JosephStew-art/autopilot-h743/README.md

STM32H743 autopilot board designed in KiCad. V2 routing is complete silkscreen cleanup remains.

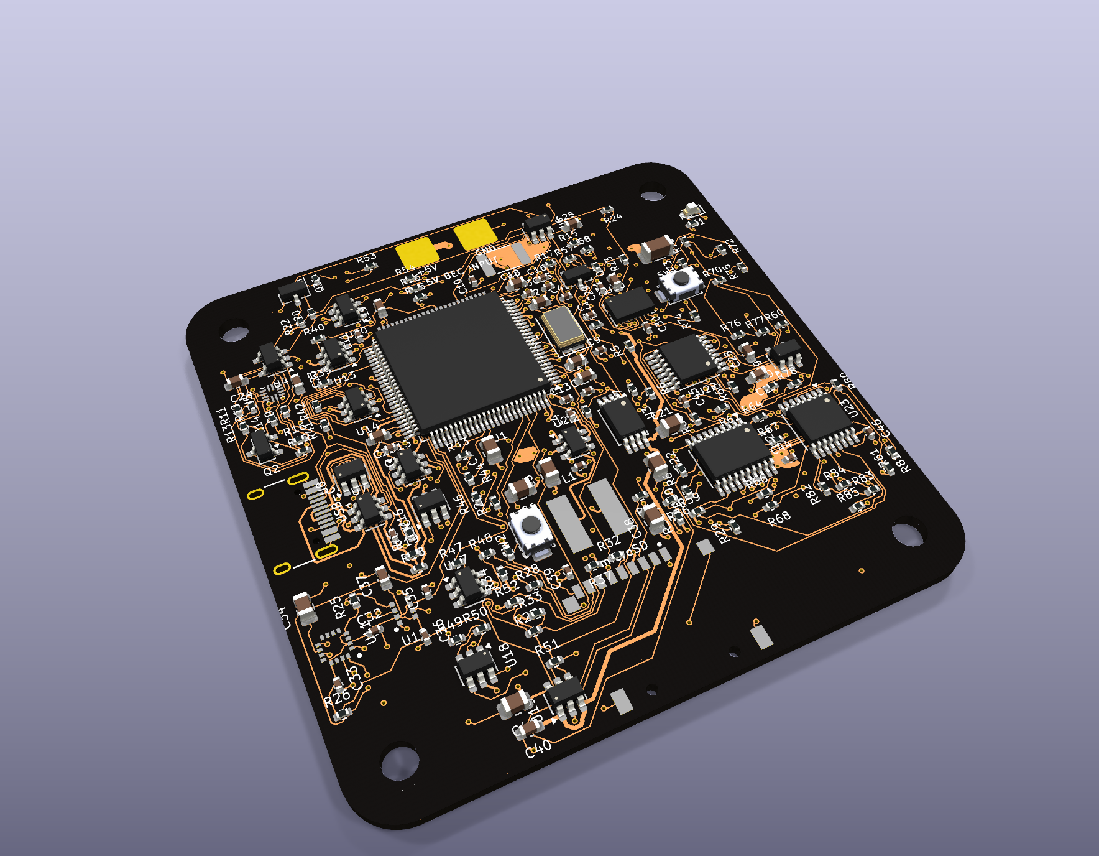
[picture p1: images/board-3d.png]
V2 board — top


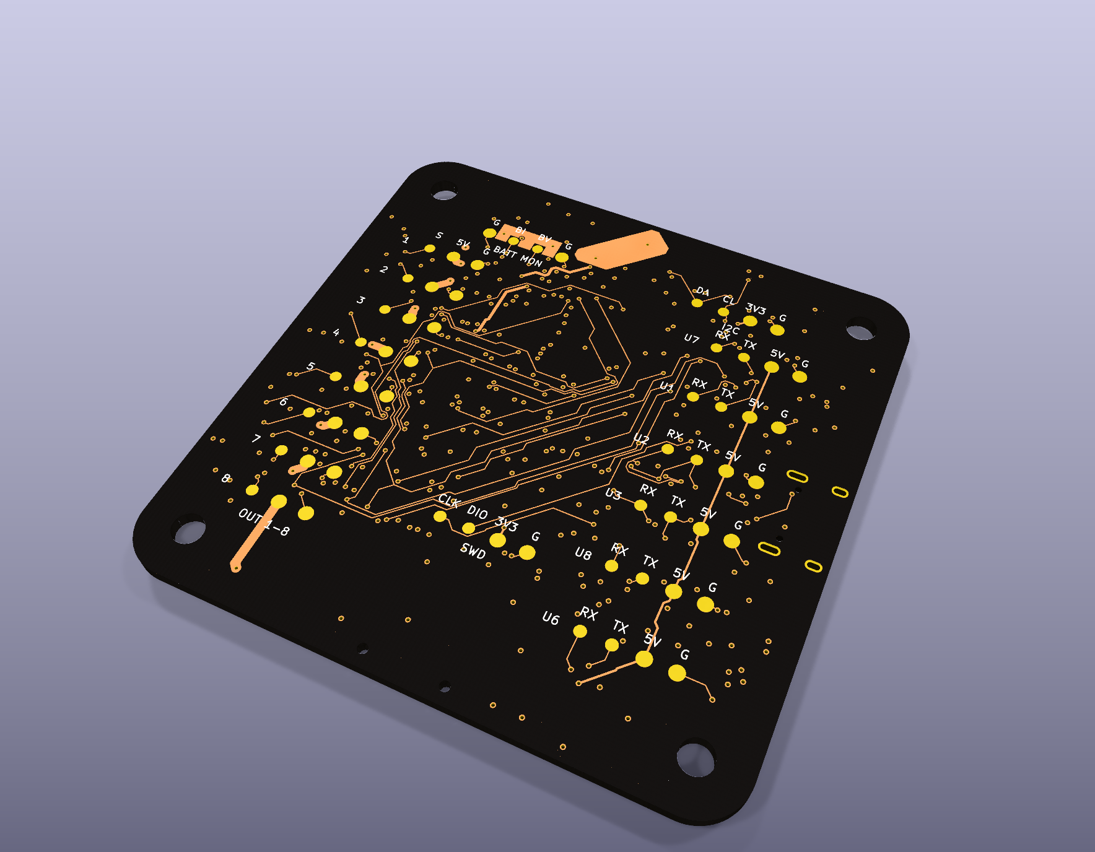
[picture p2: images/board-3d-bottom.png]
V2 board — bottom
