JosephStew-art/autopilot-h743/Autopilot_H743_V2.kicad_pcb

## KiCad design Autopilot_H743_V2.kicad_pcb (2026-10-12)

Schematic: Autopilot_H743_V2.kicad_sch, H743 compact autopilot — revision two

Parts:
C1, C2: 33pF; Capacitor_SMD__C_0603_1608Metric; Rating 33pF / 100V C0G; MPN GCM1885C2A330JA16D; LCSC C126578
C3, C4, C8, C9, C10, C11, C12, C13, C14, C15, C16, C26, C29, C30, C32, C33, C35, C36, C39, C42, C43, C44, C45, C46: 100nF; C_0402_1005Metric; Rating 100nF / 16V X7R; MPN CL05B104KO5NNNC; LCSC C1525
C5, C6, C22, C34: 22uF; Capacitor_SMD__C_0805_2012Metric; Rating 22uF / 25V X5R; MPN CL21A226MAQNNNE; LCSC C45783
C7, C21, C38, C41: 10uF; Capacitor_SMD__C_0805_2012Metric; Rating 10uF / 35V X5R; MPN GRM21BR6YA106KE43L; LCSC C162422
C17, C28: 4.7uF; Capacitor_SMD__C_0603_1608Metric; Rating 4.7uF / 16V X5R; MPN CL10A475KO8NNNC; LCSC C19666
C18, C23, C24, C25, C27, C31, C37, C40: 1uF; Capacitor_SMD__C_0603_1608Metric; Rating 1uF / 50V X5R; MPN CL10A105KB8NNNC; LCSC C15849
C19, C20: 2.2uF; Capacitor_SMD__C_0603_1608Metric; Rating 2.2uF / 16V X5R; MPN CL10A225KO8NNNC; LCSC C23630
C47: 47uF; Capacitor_SMD__C_1206_3216Metric; Rating 47uF / 10V X5R; DC-bias derating applies; MPN CL31A476MPHNNNE; LCSC C96123
D1: RED; LED_SMD__LED_0603_1608Metric; Rating RED / status; MPN KT-0603R; LCSC C2286
F1: 1.5A hold; Fuse__Fuse_1812_4532Metric; Rating 1.5A hold / 16V; MPN SMD1812P150TF/16; LCSC C20810
J2: 5V BEC INPUT PADS; PowerInput_2Pad_4x4mm_P7mm; Rating Regulated 4.75-5.25 V; shared avionics 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
J3: TYPE-C-31-M-12; Connector_USB__USB_C_Receptacle_HRO_TYPE-C-31-M-12; Rating TYPE-C-31-M-12; MPN TYPE-C-31-M-12; LCSC C165948
J4: TF-01A / microSD; TF-01A; Rating TF-01A / microSD; MPN TF-01A; LCSC C91145
L1: 4.7uH; SRN6045; Rating 4.7uH / Irms3A / Isat4A; MPN SRN6045-4R7Y; LCSC C780210
Q1: AO3401A; Package_TO_SOT_SMD__SOT-23; Rating AO3401A; MPN AO3401A; LCSC C15127
Q2: MMBT3906 PNP; Package_TO_SOT_SMD__SOT-23; Rating MMBT3906 PNP; MPN MMBT3906 2A(RANGE:100-300); LCSC C2143
Q3: MMBT2222A NPN; Package_TO_SOT_SMD__SOT-23; Rating MMBT2222A NPN; MPN MMBT2222A 1P; LCSC C8512
R1, R2, R8, R12, R13, R17, R22, R23, R24, R38, R52, R59, R60, R61: 10k; R_0402_1005Metric; Rating 10k / 1% / 62.5mW; MPN 0402WGF1002TCE; LCSC C25744
R3, R57, R58: 1k; R_0402_1005Metric; Rating 1k / 1% / 62.5mW; MPN 0402WGF1001TCE; LCSC C11702
R4, R5, R14, R16, R20, R21, R62, R63, R64, R65, R66, R67, R68, R69, R71, R73, R75, R77, R79, R81, R83, R85: 100k; R_0402_1005Metric; Rating 100k / 1% / 62.5mW; MPN 0402WGF1003TCE; LCSC C25741
R6: 24k; R_0402_1005Metric; Rating 24k / 1% / 62.5mW; MPN 0402WGF2402TCE; LCSC C25769
R7: 470; R_0402_1005Metric; Rating 470 / 1% / 62.5mW; MPN 0402WGF4700TCE; LCSC C25117
R9, R10, R11: 300k; R_0402_1005Metric; Rating 300k / 1% / 62.5mW; MPN 0402WGF3003TCE; LCSC C25774
R15: 20k; R_0402_1005Metric; Rating 20k / 1% / 62.5mW; MPN 0402WGF2002TCE; LCSC C25765
R18, R19, R27, R28, R29, R30, R31, R32, R39, R40, R41, R42, R43, R44, R45, R46, R47, R48, R49, R50, R53, R54, R70, R72, R74, R76, R78, R80, R82, R84: 33; R_0402_1005Metric; Rating 33 / 1% / 62.5mW; MPN 0402WGF330JTCE; LCSC C25105
R25, R26, R55, R56: 4.7k; R_0402_1005Metric; Rating 4.7k / 1% / 62.5mW; MPN 0402WGF4701TCE; LCSC C25900
R33, R34, R35, R36, R37, R51: 49.9k; R_0402_1005Metric; Rating 49.9k / 1% / 62.5mW; MPN 0402WGF4992TCE; LCSC C25897
SW1: RESET; SW_TS-1088-AR02016; Rating RESET; MPN TS-1088-AR02016; LCSC C720477
SW2: BOOT; SW_TS-1088-AR02016; Rating BOOT; MPN TS-1088-AR02016; LCSC C720477
TP1, TP29: V3V3_CORE; SolderPad_D1.5mm; Rating V3V3_CORE
TP2: SWDIO; SolderPad_D1.2mm; Rating SWDIO
TP3: SWCLK; SolderPad_D1.2mm; Rating SWCLK
TP4, TP8, TP12, TP16, TP20, TP24, TP28, TP32, TP33, TP36, TP37, TP40, TP43, TP46, TP49, TP52, TP55, TP58: GND; SolderPad_D1.5mm; Rating GND
TP5, TP9, TP13, TP17, TP21, TP25: V5_PERIPH; SolderPad_D1.5mm; Rating V5_PERIPH
TP6: UART7_TX_EXT; SolderPad_D1.2mm; Rating UART7_TX_EXT
TP7: UART7_RX_EXT; SolderPad_D1.2mm; Rating UART7_RX_EXT
TP10: USART1_TX_EXT; SolderPad_D1.2mm; Rating USART1_TX_EXT
TP11: USART1_RX_EXT; SolderPad_D1.2mm; Rating USART1_RX_EXT
TP14: USART2_TX_EXT; SolderPad_D1.2mm; Rating USART2_TX_EXT
TP15: USART2_RX_EXT; SolderPad_D1.2mm; Rating USART2_RX_EXT
TP18: USART3_TX_EXT; SolderPad_D1.2mm; Rating USART3_TX_EXT
TP19: USART3_RX_EXT; SolderPad_D1.2mm; Rating USART3_RX_EXT
TP22: UART8_TX_EXT; SolderPad_D1.2mm; Rating UART8_TX_EXT
TP23: UART8_RX_EXT; SolderPad_D1.2mm; Rating UART8_RX_EXT
TP26: USART6_TX_EXT; SolderPad_D1.2mm; Rating USART6_TX_EXT
TP27: USART6_RX_EXT; SolderPad_D1.2mm; Rating USART6_RX_EXT
TP30: I2C1_SCL_EXT; SolderPad_D1.2mm; Rating I2C1_SCL_EXT
TP31: I2C1_SDA_EXT; SolderPad_D1.2mm; Rating I2C1_SDA_EXT
TP34: BATT_V_IN; SolderPad_D1.2mm; Rating BATT_V_IN
TP35: BATT_I_IN; SolderPad_D1.2mm; Rating BATT_I_IN
TP38, TP41, TP44, TP47, TP50, TP53, TP56, TP59: V5_MAIN_IN; SolderPad_D1.5mm; Rating V5_MAIN_IN
TP39: PWM1_OUT; SolderPad_D1.2mm; Rating PWM1_OUT
TP42: PWM2_OUT; SolderPad_D1.2mm; Rating PWM2_OUT
TP45: PWM3_OUT; SolderPad_D1.2mm; Rating PWM3_OUT
TP48: PWM4_OUT; SolderPad_D1.2mm; Rating PWM4_OUT
TP51: PWM5_OUT; SolderPad_D1.2mm; Rating PWM5_OUT
TP54: PWM6_OUT; SolderPad_D1.2mm; Rating PWM6_OUT
TP57: PWM7_OUT; SolderPad_D1.2mm; Rating PWM7_OUT
TP60: PWM8_OUT; SolderPad_D1.2mm; Rating PWM8_OUT
U1: STM32H743VIT6; Package_QFP__LQFP-100_14x14mm_P0.5mm; Rating STM32H743VIT6; MPN STM32H743VIT6; LCSC C114409
U2: AP63203WU-7; Package_TO_SOT_SMD__TSOT-23-6; Rating AP63203WU-7; MPN AP63203WU-7; LCSC C780769
U3: TPS2113APWR; Package_SO__TSSOP-8_4.4x3mm_P0.65mm; Rating TPS2113APWR; MPN TPS2113APWR; LCSC C130052
U4, U9: TPS7A2033PDBVR; Package_TO_SOT_SMD__SOT-23-5; Rating TPS7A2033PDBVR; MPN TPS7A2033PDBVR; LCSC C2862740
U5: TUSB320LIRWBR; Package_DFN_QFN__Texas_X2QFN-12_1.6x1.6mm_P0.4mm; Rating TUSB320LIRWBR; MPN TUSB320LIRWBR; LCSC C2836598
U6, U19: TPS2553DBVR; Package_TO_SOT_SMD__SOT-23-6; Rating TPS2553DBVR; MPN TPS2553DBVR; LCSC C55266
U7, U8, U13, U14, U15, U16, U17, U18, U20: USBLC6-2SC6; Package_TO_SOT_SMD__SOT-23-6; Rating USBLC6-2SC6; MPN USBLC6-2SC6; LCSC C7519
U10: BMI088; Package_LGA__Bosch_LGA-16_4.5x3mm_P0.5mm_LayoutBorder7x1y_C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; Rating BMI088; MPN BMI088; LCSC C194919
U11: MMC5983MA; Rating MMC5983MA; MPN MMC5983MA; LCSC C404329
U12: SPA06-003; Rating SPA06-003; MPN SPA06-003; LCSC C30589048
U21: SN74LV8T245PWR; Package_SO__TSSOP-20_4.4x6.5mm_P0.65mm; Rating SN74LV8T245PWR; MPN SN74LV8T245PWR; LCSC C20345798
U22, U23: TMUX1574PWR; Package_SO__TSSOP-16_4.4x5mm_P0.65mm; Rating TMUX1574PWR; MPN TMUX1574PWR; LCSC C2673443
Y1: 8MHz; Crystal__Crystal_SMD_5032-2Pin_5.0x3.2mm; Rating 8MHz / CL20pF; MPN X50328MSB2GI; LCSC C115962

Connections:
/ACTUATOR_OE_N: R59.2, U1.57 (PD10), U21.19 (OE_N), U22.15 (EN_N), U23.15 (EN_N)
/ADC_BATT_I: C43.1, R58.2, U1.16 (PC1)
/ADC_BATT_V: C42.1, R57.2, U1.15 (PC0)
/BATT_I_IN: R58.1, TP35.1
/BATT_V_IN: R57.1, TP34.1
/BOOT0: R2.1, SW2.2, U1.94 (BOOT0)
/BUCK_BST: C4.1, U2.6 (BST)
/BUCK_SW: C4.2, L1.1, U2.5 (SW)
/CC_HIGH_CURRENT_N: R12.2, R13.1, U5.7 (OUT1)
/CC_VBUS_DET: R11.2, U5.4 (VBUS_DET)
/CC_VBUS_R1: R9.2, R10.1
/CC_VBUS_R2: R10.2, R11.1
/GND: C1.2, C2.2, C3.2, C5.2, C6.2, C7.2, C8.2, C9.2, C10.2, C11.2, C12.2, C13.2, C14.2, C15.2, C16.2, C17.2, C18.2, C19.2, C20.2, C21.2, C22.2, C23.2, C24.2, C25.2, C26.2, C27.2, C28.2, C29.2, C30.2, C31.2, C32.2, C33.2, C34.2, C35.2, C36.2, C37.2, C38.2, C39.2, C40.2, C41.2, C42.2, C43.2, C44.2, C45.2, C46.2, C47.2, D1.1 (K), J2.1 (GND), J3.A1 (GND), J3.A12 (GND), J3.B1 (GND), J3.B12 (GND), J3.S1 (SHIELD), J4.6 (VSS), J4.10 (SHIELD), Q3.2 (E), R2.2, R4.2, R6.2, R7.2, R15.2, R16.2, R21.2, R51.2, R60.2, R61.2, R62.2, R63.2, R64.2, R65.2, R66.2, R67.2, R68.2, R69.2, R71.2, R73.2, R75.2, R77.2, R79.2, R81.2, R83.2, R85.2, SW1.2, TP4.1, TP8.1, TP12.1, TP16.1, TP20.1, TP24.1, TP28.1, TP32.1, TP33.1, TP36.1, TP37.1, TP40.1, TP43.1, TP46.1, TP49.1, TP52.1, TP55.1, TP58.1, U1.10 (VSS), U1.19 (VSSA), U1.26 (VSS), U1.49 (VSS), U1.74 (VSS), U1.99 (VSS), U2.4 (GND), U3.2 (EN_N), U3.5 (GND), U4.2 (GND), U5.3 (PORT), U5.10 (GND), U5.11 (EN_N), U6.2 (GND), U7.2 (GND), U8.2 (GND), U9.2 (GND), U10.2 (GNDA), U10.4 (GNDA), U10.6 (GNDIO), U10.7 (PS), U11.9 (GND), U11.11 (GND), U12.1 (GND), U12.5 (ADDR_I2C), U12.7 (GND), U13.2 (GND), U14.2 (GND), U15.2 (GND), U16.2 (GND), U17.2 (GND), U18.2 (GND), U19.2 (GND), U20.2 (GND), U21.10 (GND), U22.8 (GND), U23.8 (GND)
/HSE_IN: C1.1, U1.12 (PH0), Y1.1
/HSE_OUT: C2.1, U1.13 (PH1), Y1.2
/I2C1_SCL: R53.1, R55.2, U1.92 (PB6)
/I2C1_SCL_EXT: R53.2, TP30.1, U20.1 (I/O1), U20.6 (I/O1)
/I2C1_SDA: R54.1, R56.2, U1.93 (PB7)
/I2C1_SDA_EXT: R54.2, TP31.1, U20.3 (I/O2), U20.4 (I/O2)
/I2C2_SCL: R25.2, U1.46 (PB10), U11.1 (SCL), U12.4 (SCK)
/I2C2_SDA: R26.2, U1.47 (PB11), U11.16 (SDA), U12.3 (SDA)
/IMU_ACC_CS_N: R23.2, U1.9 (PC15), U10.14 (~CSB1)
/IMU_ACC_INT: U1.7 (PC13), U10.16 (INT1)
/IMU_GYR_CS_N: R24.2, U1.8 (PC14), U10.5 (~CSB2)
/IMU_GYR_INT: U1.1 (PE2), U10.12 (INT3)
/LED_STATUS_A: D1.2 (A), R3.2
/MAG_INT: U1.3 (PE4), U11.15 (INT)
/MAG_SETRESET_CAP: C34.1, U11.10 (CAP)
/MAIN_PMOS_GATE: Q1.1 (G), R4.1
/MAIN_VSNS: R5.2, R6.1, U3.3 (VSNS)
/MUX_ILIM: R7.1, U3.4 (ILIM)
/NRST: C3.1, R1.2, SW1.1, U1.14 (NRST)
/OTG_FS_DM: R19.2, U1.70 (PA11)
/OTG_FS_DP: R18.2, U1.71 (PA12)
/OUT_BANK1_DSHOT: R60.1, U1.58 (PD11), U22.1 (SEL_DSHOT)
/OUT_BANK2_DSHOT: R61.1, U1.84 (PD3), U23.1 (SEL_DSHOT)
/PERIPH_FAULT_N: R52.2, U1.4 (PE5), U19.4 (FAULT_N)
/PERIPH_ILIM: R51.1, U19.5 (ILIM)
/PWM1_5V: U21.18 (B1), U22.2 (S1A_PWM5V)
/PWM1_MCU: R62.1, U1.22 (PA0), U21.2 (A1), U22.3 (S1B_DSHOT)
/PWM1_OUT: R70.2, R71.1, TP39.1
/PWM1_SELECTED: R70.1, U22.4 (D1)
/PWM2_5V: U21.17 (B2), U22.5 (S2A_PWM5V)
/PWM2_MCU: R63.1, U1.23 (PA1), U21.3 (A2), U22.6 (S2B_DSHOT)
/PWM2_OUT: R72.2, R73.1, TP42.1
/PWM2_SELECTED: R72.1, U22.7 (D2)
/PWM3_5V: U21.16 (B3), U22.11 (S3A_PWM5V)
/PWM3_MCU: R64.1, U1.24 (PA2), U21.4 (A3), U22.10 (S3B_DSHOT)
/PWM3_OUT: R74.2, R75.1, TP45.1
/PWM3_SELECTED: R74.1, U22.9 (D3)
/PWM4_5V: U21.15 (B4), U22.14 (S4A_PWM5V)
/PWM4_MCU: R65.1, U1.25 (PA3), U21.5 (A4), U22.13 (S4B_DSHOT)
/PWM4_OUT: R76.2, R77.1, TP48.1
/PWM4_SELECTED: R76.1, U22.12 (D4)
/PWM5_5V: U21.14 (B5), U23.2 (S1A_PWM5V)
/PWM5_MCU: R66.1, U1.59 (PD12), U21.6 (A5), U23.3 (S1B_DSHOT)
/PWM5_OUT: R78.2, R79.1, TP51.1
/PWM5_SELECTED: R78.1, U23.4 (D1)
/PWM6_5V: U21.13 (B6), U23.5 (S2A_PWM5V)
/PWM6_MCU: R67.1, U1.60 (PD13), U21.7 (A6), U23.6 (S2B_DSHOT)
/PWM6_OUT: R80.2, R81.1, TP54.1
/PWM6_SELECTED: R80.1, U23.7 (D2)
/PWM7_5V: U21.12 (B7), U23.11 (S3A_PWM5V)
/PWM7_MCU: R68.1, U1.61 (PD14), U21.8 (A7), U23.10 (S3B_DSHOT)
/PWM7_OUT: R82.2, R83.1, TP57.1
/PWM7_SELECTED: R82.1, U23.9 (D3)
/PWM8_5V: U21.11 (B8), U23.14 (S4A_PWM5V)
/PWM8_MCU: R69.1, U1.62 (PD15), U21.9 (A8), U23.13 (S4B_DSHOT)
/PWM8_OUT: R84.2, R85.1, TP60.1
/PWM8_SELECTED: R84.1, U23.12 (D4)
/PWR_USB_SELECTED: R8.2, U1.96 (PB9), U3.1 (STAT)
/SDMMC1_CK: R32.1, U1.80 (PC12)
/SDMMC1_CMD: R31.1, U1.83 (PD2)
/SDMMC1_D0: R27.1, U1.65 (PC8)
/SDMMC1_D1: R28.1, U1.66 (PC9)
/SDMMC1_D2: R29.1, U1.78 (PC10)
/SDMMC1_D3: R30.1, U1.79 (PC11)
/SD_CLK_CARD: J4.5 (CLK), R32.2
/SD_CMD_CARD: J4.3 (CMD), R31.2, R37.2
/SD_D0_CARD: J4.7 (DAT0), R27.2, R33.2
/SD_D1_CARD: J4.8 (DAT1), R28.2, R34.2
/SD_D2_CARD: J4.1 (DAT2), R29.2, R35.2
/SD_D3_CARD: J4.2 (DAT3), R30.2, R36.2
/SD_DETECT_N: J4.9 (CD), R38.2, U1.95 (PB8)
/SPI1_MISO: U1.30 (PA6), U10.10 (SDO2), U10.15 (SDO1)
/SPI1_MOSI: U1.88 (PD7), U10.9 (SDI/SDA)
/SPI1_SCK: U1.29 (PA5), U10.8 (SCK/SCL)
/STATUS_LED: R3.1, U1.2 (PE3)
/SWCLK: TP3.1, U1.76 (PA14)
/SWDIO: TP2.1, U1.72 (PA13)
/UART7_RX: R40.2, U1.37 (PE7)
/UART7_RX_EXT: R40.1, TP7.1, U13.3 (I/O2), U13.4 (I/O2)
/UART7_TX: R39.1, U1.38 (PE8)
/UART7_TX_EXT: R39.2, TP6.1, U13.1 (I/O1), U13.6 (I/O1)
/UART8_RX: R48.2, U1.97 (PE0)
/UART8_RX_EXT: R48.1, TP23.1, U17.3 (I/O2), U17.4 (I/O2)
/UART8_TX: R47.1, U1.98 (PE1)
/UART8_TX_EXT: R47.2, TP22.1, U17.1 (I/O1), U17.6 (I/O1)
/USART1_RX: R42.2, U1.69 (PA10)
/USART1_RX_EXT: R42.1, TP11.1, U14.3 (I/O2), U14.4 (I/O2)
/USART1_TX: R41.1, U1.68 (PA9)
/USART1_TX_EXT: R41.2, TP10.1, U14.1 (I/O1), U14.6 (I/O1)
/USART2_RX: R44.2, U1.87 (PD6)
/USART2_RX_EXT: R44.1, TP15.1, U15.3 (I/O2), U15.4 (I/O2)
/USART2_TX: R43.1, U1.86 (PD5)
/USART2_TX_EXT: R43.2, TP14.1, U15.1 (I/O1), U15.6 (I/O1)
/USART3_RX: R46.2, U1.56 (PD9)
/USART3_RX_EXT: R46.1, TP19.1, U16.3 (I/O2), U16.4 (I/O2)
/USART3_TX: R45.1, U1.55 (PD8)
/USART3_TX_EXT: R45.2, TP18.1, U16.1 (I/O1), U16.6 (I/O1)
/USART6_RX: R50.2, U1.64 (PC7)
/USART6_RX_EXT: R50.1, TP27.1, U18.3 (I/O2), U18.4 (I/O2)
/USART6_TX: R49.1, U1.63 (PC6)
/USART6_TX_EXT: R49.2, TP26.1, U18.1 (I/O1), U18.6 (I/O1)
/USB_CC1: J3.A5 (CC1), U5.1 (CC1), U8.1 (I/O1), U8.6 (I/O1)
/USB_CC2: J3.B5 (CC2), U5.2 (CC2), U8.3 (I/O2), U8.4 (I/O2)
/USB_CONN_DM: J3.A7 (D-), J3.B7 (D-), R19.1, U7.3 (I/O2), U7.4 (I/O2)
/USB_CONN_DP: J3.A6 (D+), J3.B6 (D+), R18.1, U7.1 (I/O1), U7.6 (I/O1)
/USB_DETECT_BASE: Q3.1 (B), R20.2, R21.1
/USB_EN_PNP_BASE: Q2.1 (B), R13.2, R14.1
/USB_FAULT_N: R17.2, U1.5 (PE6), U6.4 (FAULT_N)
/USB_ILIM: R15.1, U6.5 (ILIM)
/USB_PRESENT_N: Q3.3 (C), R22.2, U1.32 (PC4)
/USB_PWR_EN: Q2.3 (C), R16.1, U6.3 (EN)
/USB_VBUS: C23.1, C26.1, J3.A4 (VBUS), J3.A9 (VBUS), J3.B4 (VBUS), J3.B9 (VBUS), R9.1, R20.1, U4.1 (IN), U4.3 (EN), U6.1 (IN), U7.5 (VBUS), U8.5 (VBUS)
/V3V3_CC: C24.1, Q2.2 (E), R12.1, R14.2, U4.5 (OUT_3V3), U5.12 (VDD)
/V3V3_CORE: C5.1, C6.1, C9.1, C10.1, C11.1, C12.1, C13.1, C14.1, C15.1, C16.1, C17.1, C18.1, C38.1, C39.1, J4.4 (VDD), L1.2, R1.1, R8.1, R17.1, R22.1, R33.1, R34.1, R35.1, R36.1, R37.1, R38.1, R52.1, R55.1, R56.1, R59.1, SW2.1, TP1.1, TP29.1, U1.6 (VBAT), U1.11 (VDD), U1.20 (VREF+), U1.21 (VDDA), U1.27 (VDD), U1.50 (VDD), U1.75 (VDD), U1.100 (VDD), U2.1 (FB), U13.5 (VBUS), U14.5 (VBUS), U15.5 (VBUS), U16.5 (VBUS), U17.5 (VBUS), U18.5 (VBUS), U20.5 (VBUS)
/V3V3_SENS: C28.1, C29.1, C30.1, C31.1, C32.1, C33.1, C35.1, C36.1, C37.1, R23.1, R24.1, R25.1, R26.1, U9.5 (OUT_3V3), U10.3 (VDD), U10.11 (VDDIO), U11.2 (VDD), U11.4 (CS_N), U11.13 (VDDIO), U12.2 (CSB), U12.6 (VDDIO), U12.8 (VDD)
/V5_MAIN_FUSED: F1.2, Q1.3 (D)
/V5_MAIN_IN: C47.1, F1.1, J2.2 (+5V), TP38.1, TP41.1, TP44.1, TP47.1, TP50.1, TP53.1, TP56.1, TP59.1
/V5_MAIN_PROT: C21.1, C40.1, Q1.2 (S), R5.1, U3.8 (IN1_MAIN), U19.1 (IN), U19.3 (EN)
/V5_PERIPH: C41.1, TP5.1, TP9.1, TP13.1, TP17.1, TP21.1, TP25.1, U19.6 (OUT)
/V5_SYS: C7.1, C8.1, C22.1, C27.1, C44.1, C45.1, C46.1, U2.2 (EN), U2.3 (IN), U3.7 (OUT), U9.1 (IN), U9.3 (EN), U21.1 (DIR_A_TO_B), U21.20 (VCC), U22.16 (VDD), U23.16 (VDD)
/V5_USB_LIMIT: C25.1, U3.6 (IN2_USB), U6.6 (OUT)
/VCAP_48: C19.1, U1.48 (VCAP)
/VCAP_73: C20.1, U1.73 (VCAP)

Notes on the sheet:
15 USART2 / 3.3V UART
Default-current USB hosts may not supply the complete board load.
TX/RX names are from the autopilot. V5_PERIPH shared across ports.
OUT 8
8MHz crystal: keep loop short. SWD 3V3 pad is a voltage reference. Hold BOOT, pulse RESET for ROM loader.
21 Output bank 2 / PWM or bidirectional DShot
OUT 1
OUT 4
pin 21
One physical STM32H743VIT6, original v1 symbol and pinout. C9–C16: 100nF per supply pin; place at the pin on PCB. NC crosses retain the intentionally unused v1 pins.
22 Servo power pads / electrical notes
No IMU heater. Place bypass at supply pins; keep buck heat away.
pin 50
OUT 2
No CLK pullup. 33Ω series resistors at MCU; bypass at card socket.
SEL low = 5V PWM; high = direct 3.3V DShot. OE high = disabled.
pin 11
USB data: route as a 90Ω differential pair; minimize stubs. ESD parts at connector. R18 / R19 near MCU. USB-C and bench-power behavior are retained from v1.
06 MCU clock / reset / boot / debug
19 Eight-channel 3.3V → 5V PWM buffer
03 3.3V buck regulator
16 USART3 / 3.3V UART
10 microSD / SDMMC
J2: pad 2 +5V, pad 1 GND. Regulated 4.75-5.25 V only. Servo feed branches BEFORE F1.
VREF+ / pin 20
14 USART1 / 3.3V UART
pin 6
07 USB-C connector / data and CC protection
18 USART6 / 3.3V UART
pin 75
CC_HIGH_CURRENT_N permits bench power when Type-C advertises 1.5A / 3A.
17 UART8 / 3.3V UART
09 Compass / barometer / I2C2 pullups
V5_MAIN_IN feeds servos directly from J2; USB powers avionics only. Servo current bypasses F1, Q1 and U3; no onboard servo fuse or reverse protection. Route +5V and GND with broad copper; size both for combined stall/startup current. Return servo current toward J2, away from sensor circuitry; use p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
12 External I2C / battery-monitor inputs
20 Output bank 1 / PWM or bidirectional DShot
OUT 7
OUT 3
DIR tied high: A→B. OE high disables buffer and both output selectors.
11 Peripheral 5V / USB-present detection
pin 100
04 USB-C current detection / controller supply
OUT 6
02 Regulated 5V input / source selection
OUT 5
Keep barometer port clear. Place compass away from power-current loops.
VCAP: 2.2uF each; no external load.
pin 27
01 MCU / local bypass
Battery inputs: conditioned 0–3.3V only. 6S / 60A monitor remains external.
05 Sensor supply / BMI088 IMU
13 UART7 / 3.3V UART
V5_PERIPH is main-powered only. ~0.5A shared by all ports. USB_PRESENT_N is active low.
C4 connects BST to SW. Keep input / switching loops short. Take feedback from the output capacitors; keep SW away from sensors. Bulk capacitors retain their v1 packages and ratings.
08 USB bench-power enable / current limit

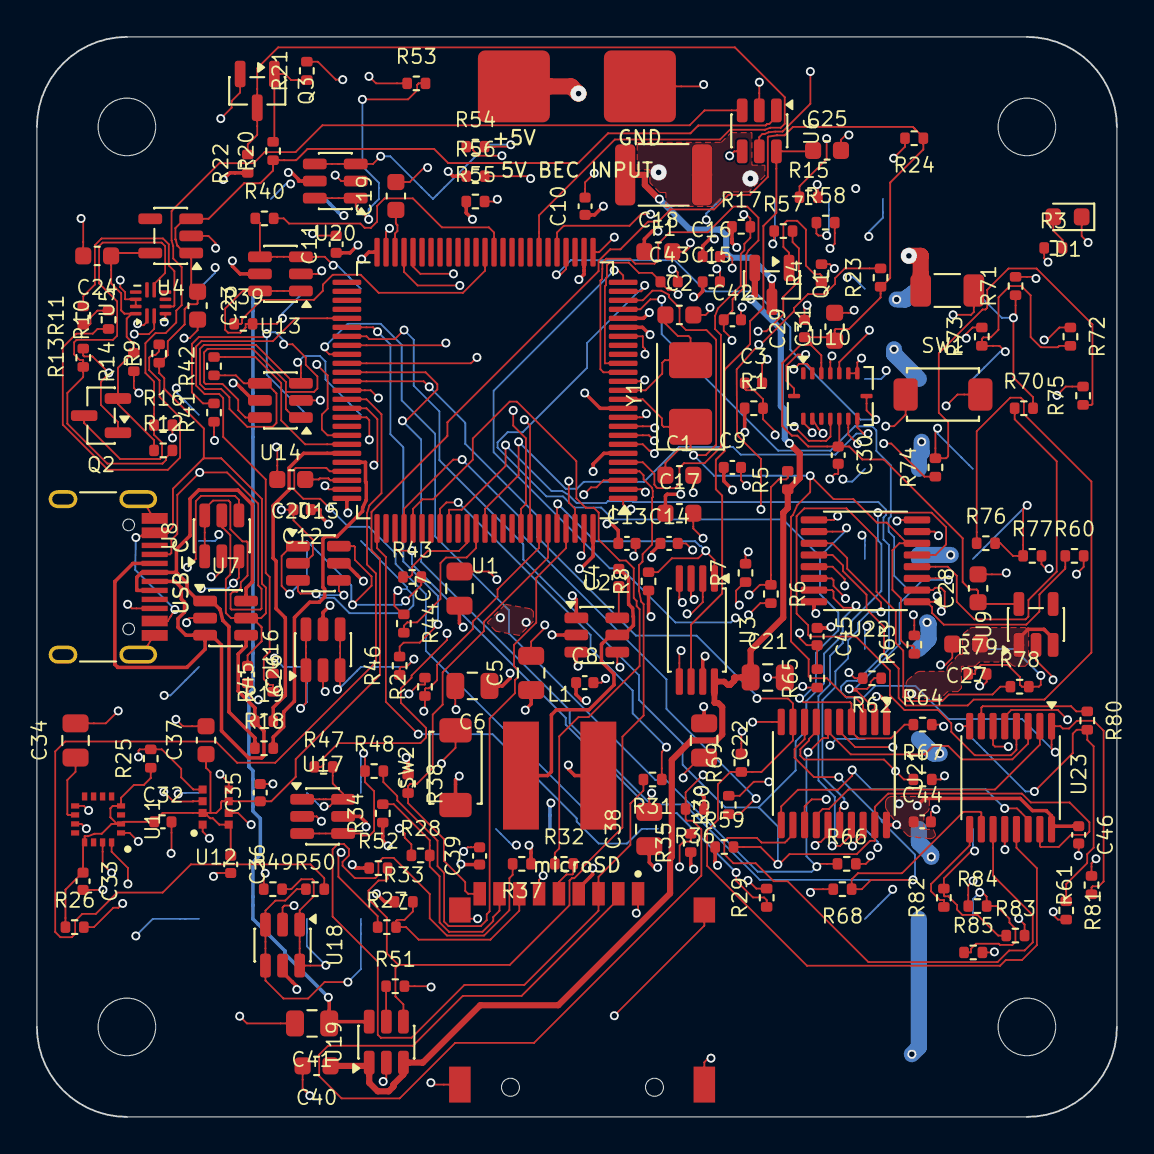
[picture p3: board Autopilot_H743_V2.kicad_pcb from above]

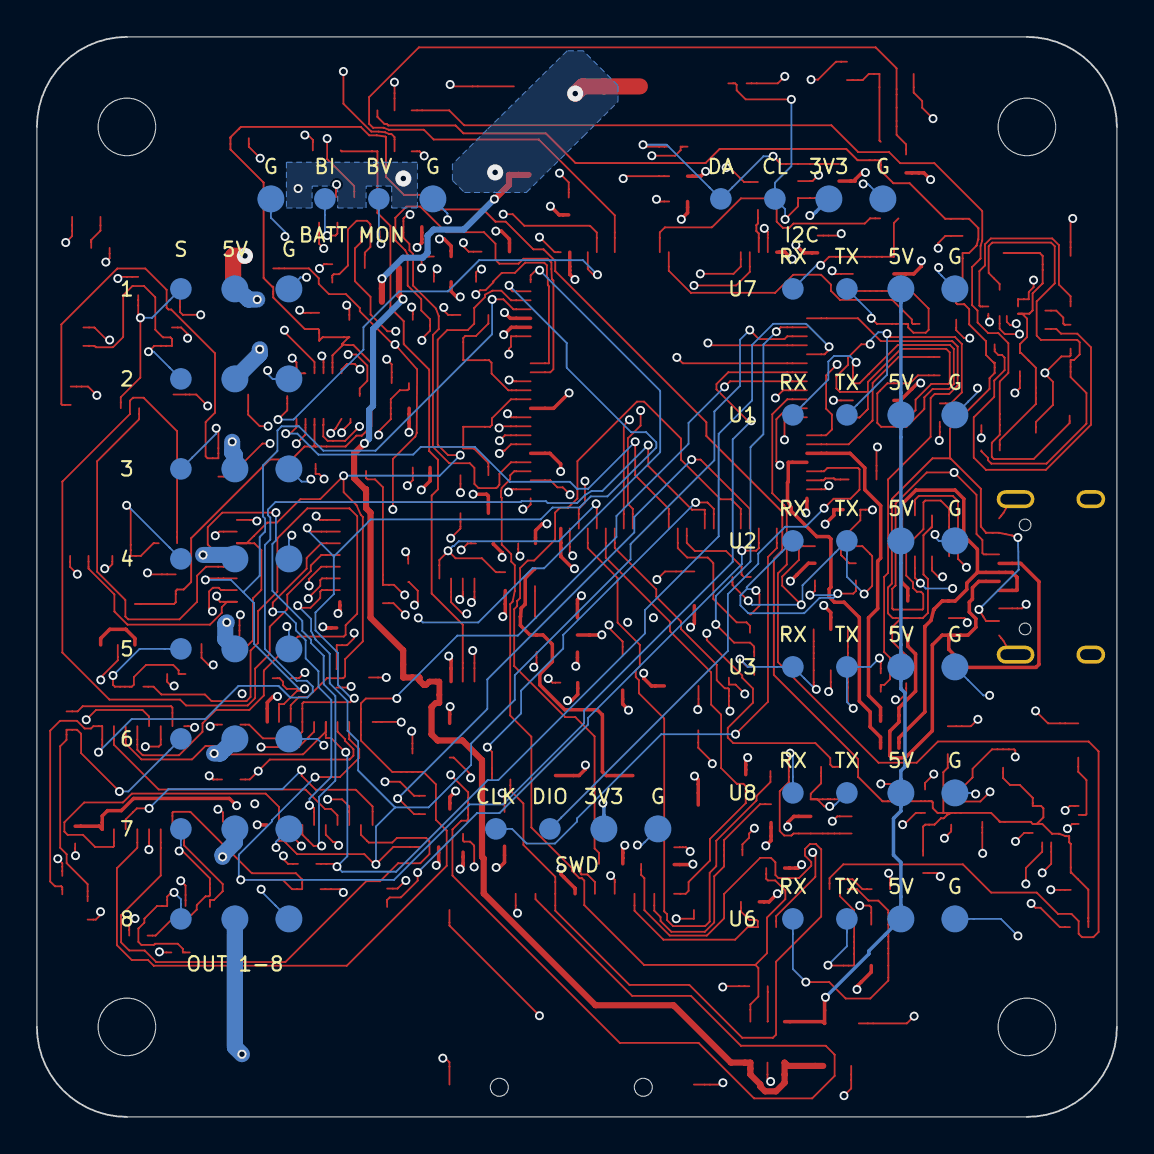
[picture p4: board Autopilot_H743_V2.kicad_pcb from below]

Board: 6 copper layers, 60.0 x 60.0 mm, 231 parts (60 on the bottom side), 136 nets.

Other parts of the board:
H1, H2, H3, H4: M3 / 50mm centres; MountingHole_3.2mm_M3
