JosephStew-art/autopilot-h743/(commit log)

2026-10-11 Initial v1 board design
    DRC has not passed. Two traces remain unrouted.
    [01_MCU.kicad_sch, 02_Decoupling.kicad_sch, 03_Power_Input.kicad_sch, 04_USB_Power.kicad_sch, 05_USB_Data.kicad_sch, 06_IMU.kicad_sch, 07_Compass_Baro.kicad_sch, 08_Storage.kicad_sch]
2026-10-12 Start compact v2 with a single-sheet schematic
    Replace external headers with 60 solder pads and use a regulated 5 V XT30 input. Retain USB-C and microSD, omit the IMU heater, and reduce 100 nF capacitors and signal/bias resistors to 0402. Preserve existing MCU pin assignments and signal net names.
    Schematic ERC reports zero violations and the PCB has zero schematic parity issues. The six-layer 50 x 50 mm PCB is a provisional unplaced, unrouted starter. DRC has not passed: 487 unconnected items and one microSD footprint pad-clearance violation remain. V1 remains available on its original branch.
    [01_MCU.kicad_sch, 02_Decoupling.kicad_sch, 03_Power_Input.kicad_sch, 04_USB_Power.kicad_sch, 05_USB_Data.kicad_sch, 06_IMU.kicad_sch, 07_Compass_Baro.kicad_sch, 08_Storage.kicad_sch]
2026-10-12 Redraw v2 with the original MCU and boxed subsystems
    Restore one original STM32H743 symbol with labeled signals and local bypass capacitors. Draw 22 rectangular subsystem blocks with labeled interfaces and short, explicit local wiring. Update the schematic preview and synchronize generated MCU no-connect net names in the PCB.
    Validation: zero ERC violations; all 137 named v1 nets, 624 connected pins and 44 unused pins preserved after the approved connector-to-pad and XT30 mapping. Existing v2 BOM and connectivity are unchanged. Zero PCB schematic parity issues. PCB geometry is unchanged; placement/routing are unfinished and DRC has not passed (one clearance violation and 487 unconnected ite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
    [Autopilot_H743_V2.kicad_pcb, Autopilot_H743_V2.kicad_sch]
2026-10-12 Shrink v2 solder pads and place peripherals with M3 mounting
    Use underside 1.2 mm signal and 1.5 mm power/ground pads, a 40 mm placement target and 30.5 mm mounting centres. Correct XT30 sourcing to AMASS XT30PW-M30.G.Y / C431092. Preserve existing internal footprint arrangement and project constraints.
    ERC and schematic parity pass. DRC has NOT passed: 487 unconnected items remain, with internal placement and all routing still pending. Add top/bottom peripheral placement preview with simplified connector bodies.
    [Autopilot_H743_V2.kicad_pcb, Autopilot_H743_V2.kicad_sch]
2026-10-12 Use solder-pad 5V input and shared servo supply; DRC not passed
    Replace XT30 with ordinary 4 x 4 mm power pads. Feed servo power from V5_MAIN_IN before avionics protection, retaining USB-only logic power. Add C47 local decoupling and power routing notes/preset. ERC and schematic parity pass; board remains unrouted with 490 unconnected items and 282 parked-component DRC violations.
    [Autopilot_H743_V2.kicad_pcb, Autopilot_H743_V2.kicad_sch]
2026-10-12 Expand v2 to 60mm with 50mm M3 mounting; DRC not passed
    Redistribute underside peripheral pads at 3mm column pitch, 7mm UART row pitch and 5mm servo row pitch. Move power pads, USB-C and microSD to the new edges. Preserve the saved internal placements and project settings. ERC passes and all 180 nets are unchanged; internal placement and routing remain unfinished, with 490 unconnected items.
    [Autopilot_H743_V2.kicad_pcb, Autopilot_H743_V2.kicad_sch]
2026-10-12 Complete V2 routing; silkscreen cleanup remains
    Finish the Quilter-routed board with the IMU chip-select connection, local MISO/gyro trace adjustments, the U21 power connection, and USB via clearance correction. Refill copper and align project rules with the selected fabrication budget.
    Verification: 0 DRC errors, 0 unrouted connections, and 0 schematic parity issues. The remaining 201 warnings concern silkscreen and still need cleanup.
    Replace the previous README images with one angled 3D render and keep the README to one line.
    [Autopilot_H743_V2.kicad_pcb]
